AdrianCX/picohive-epaper/README.md

# Pico Planner

Standalone Raspberry Pi Pico 2 W E-Paper calendar \
Show next week items from Google Calendar\
Runs for 2 months on 4 AA Batteries

### Easy to check in the morning when it's hectic

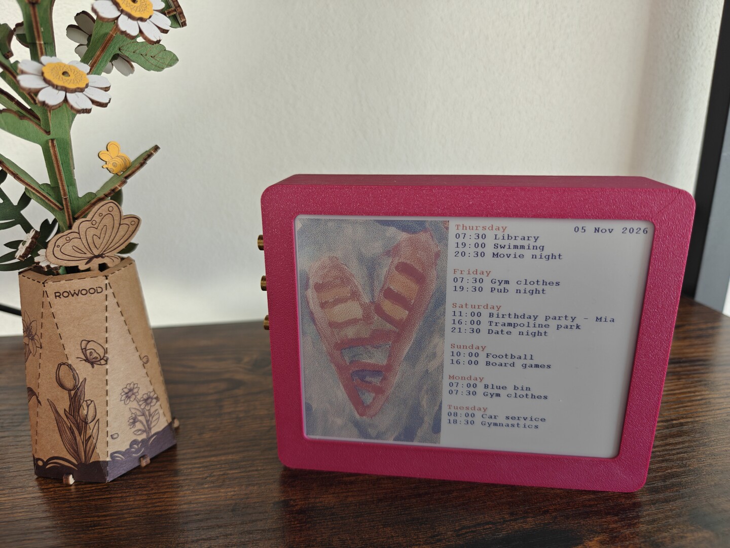
[picture p1: docs/pictures/1_main.jpg]
Standing in a bookshelf


### Simple build, few components

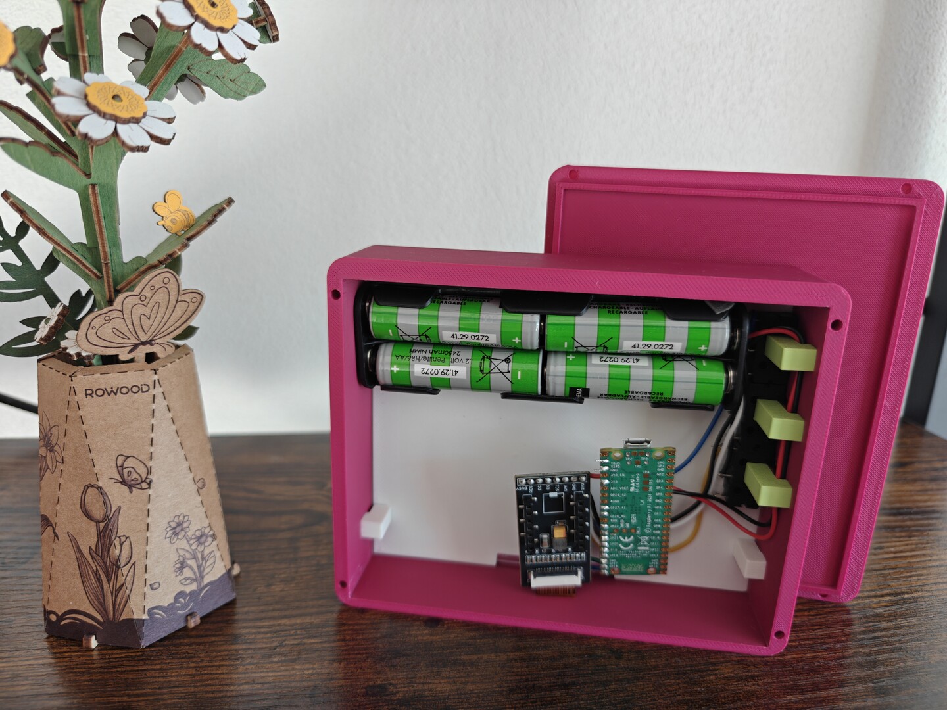
[picture p2: docs/pictures/2_back.jpg]
Inside


### How it looks disassembled

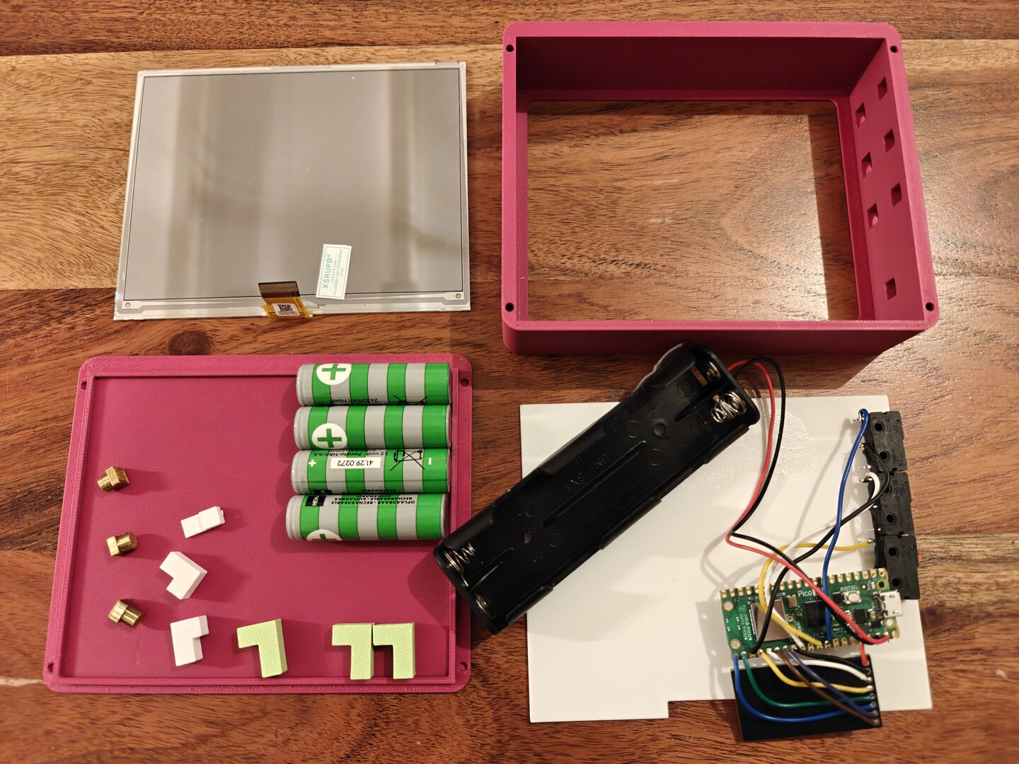
[picture p3: docs/assembly/1_assembly.jpg]
Putting it together


# Flashing and configuring

Check releases - two variants
- `epaper_color.uf2` - 5.65" 7 colour panel, 600x448 (Waveshare Pico-ePaper-5.65)
- `epaper_rb.uf2` - 5.83" black/white/red panel, 648x480 (Waveshare Pico-ePaper-5.83 (B))

Once flashed it will start in setup mode `picow_config` / `randompassword` ( http://192.168.4.1 ) \
Press KEY2 (GP26) to enter setup mode again\
Press KEY1 (GP22) to enter config mode and access on LAN

| | |
|---|---|
| Configure via web page, first wifi and login | Second, calendars and timezone |
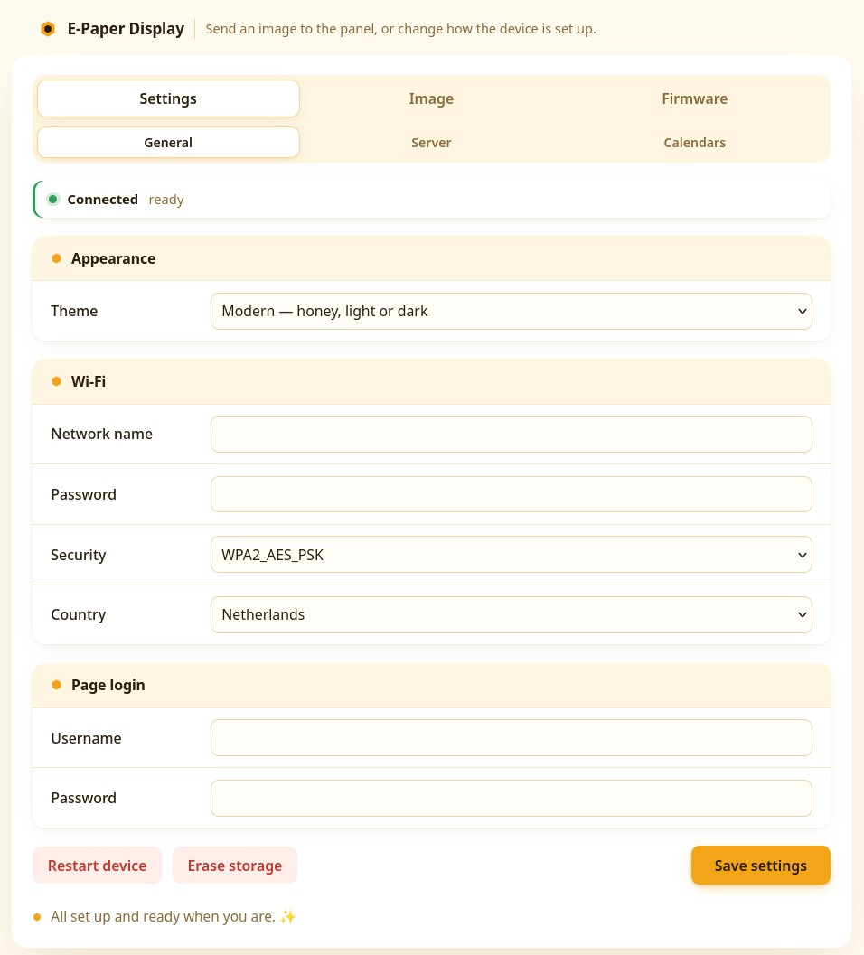
[picture p4: docs/webui/1_wifi.jpg]
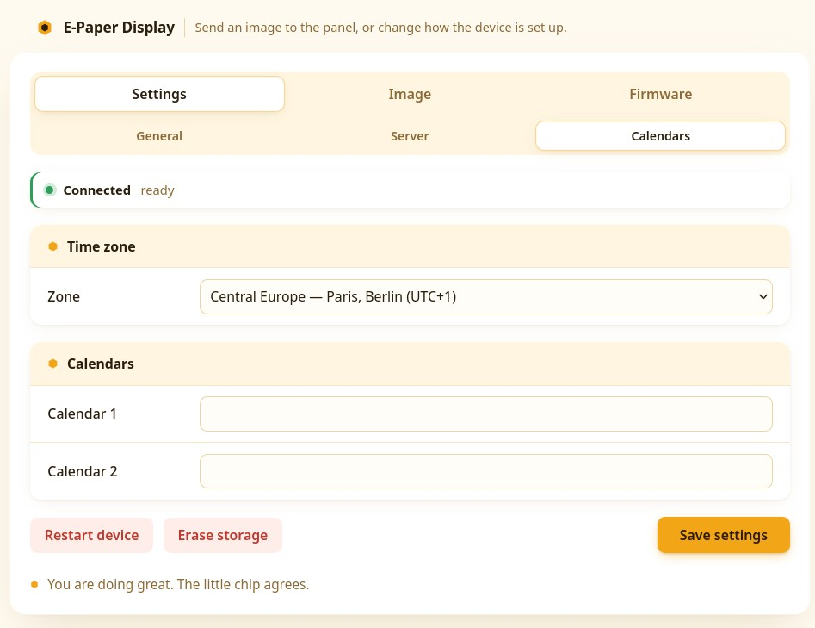
[picture p5: docs/webui/2_calendars.jpg]
|  |  |
| Third, pictures, limited slots | Last, updates go here when needed |
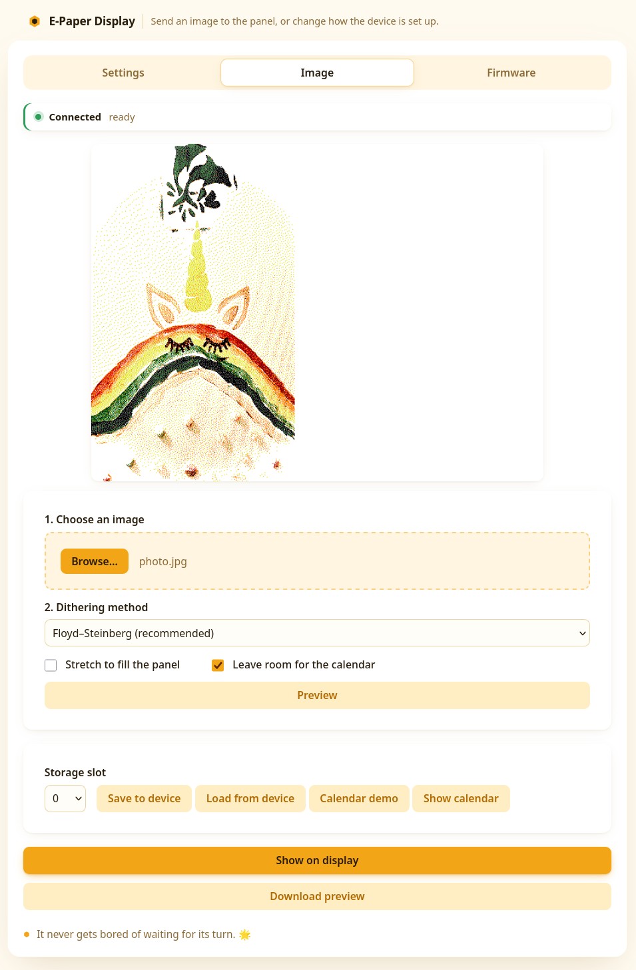
[picture p6: docs/webui/3_newpictures.jpg]
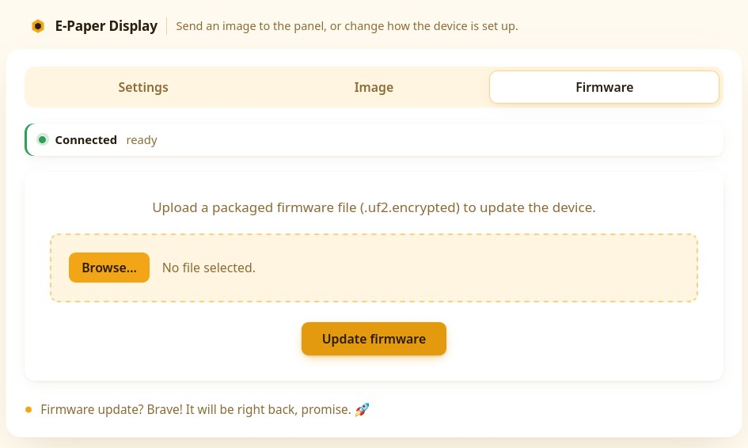
[picture p7: docs/webui/4_update.jpg]
|  |  |

Any iCal URL works (Google, Nextcloud, ...) \
It has a lot of goodies from [picohive-firmware](https://github.com/AdrianCX/picohive-firmware) like OTA, logs, crash reports ...\
You can set your own pictures from the web page, it dithers them itself

# How to get a calendar address from google

1. Open on desktop site [calendar.google.com](https://calendar.google.com)
2. Hover over calendar in "My calendars" and press the 3 dots then "Settings and Sharing"
3. Scroll down to "Secret address in iCal format" and copy that
4. Paste the calendar in the web page, save and reboot for it to be grabbed.

Notes:
- Web page stores config encrypted, doesn't echo or print it
- Calendar is fetched over HTTPS with root cert verification
- If you think it's leaked - there's a Reset button in google calendar to invalidate it

> [!TIP]
> To wipe it, flash [`flash_nuke.uf2`](https://github.com/Gadgetoid/pico-universal-flash-nuke) then the firmware again

# Firmware tutorial and build

Check out docs in [picohive-firmware](https://github.com/AdrianCX/picohive-firmware)

# How to build one

About 30€ for the red/black/white version, 45€ for the 7 colour one, plus printing (see 4.2):

| Part | Price |
|---|---|
| E-ink panel option 1: 5.83" black/white/red (648x480) | 14$ |
| E-ink panel option 2: 5.65" 7 colour (600x448)| 29$ |
| Raspberry Pi Pico 2 W | 9€ |
| ePaper breakout board for XIAO | 5€ |
| 4xAA battery holder with wires (NiMH rechargeables) | - |
| 3 push buttons, some wire | - |
| 3D printed frame, back and supports | - |

The holders plug into holes in the support, it all comes together without any screws. Use some superglue or tape and you're set.
If you need to adjust parts check out stl/scad folder - openscad is awesome

Assembly step 1

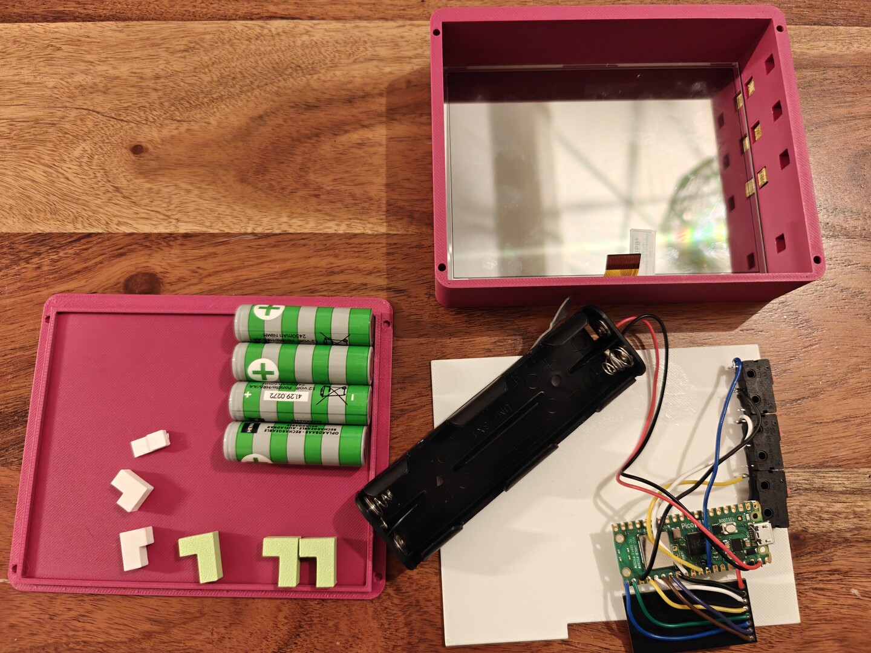
[picture p8: docs/assembly/2_assembly.jpg]
Assembly step 2


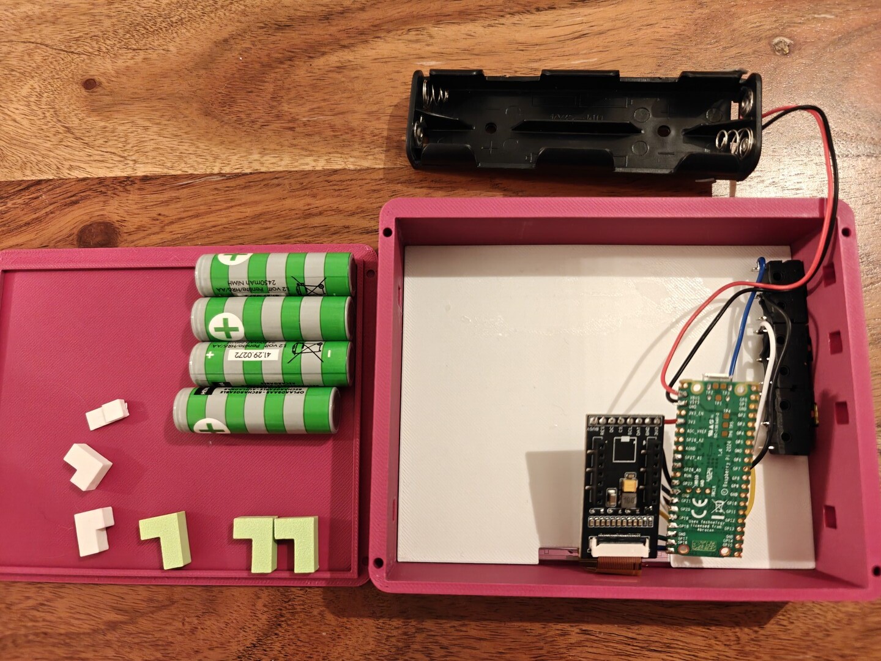
[picture p9: docs/assembly/3_assembly.jpg]
Assembly step 3


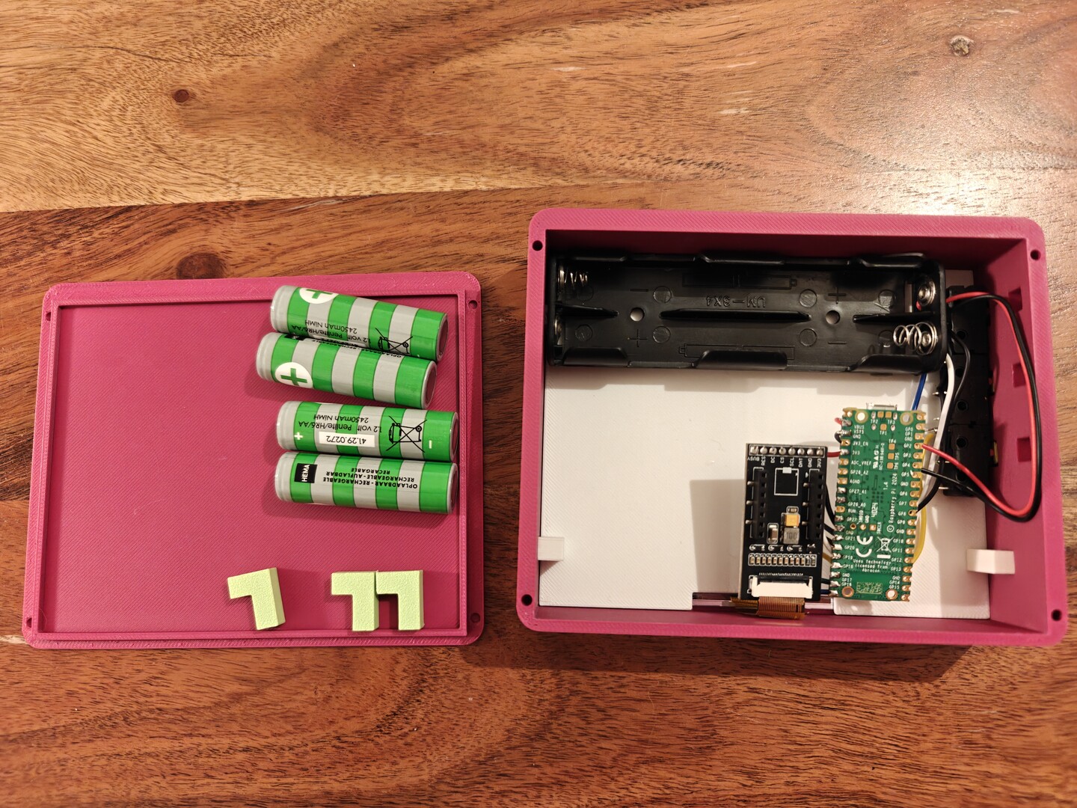
[picture p10: docs/assembly/4_assembly.jpg]
Assembly step 4


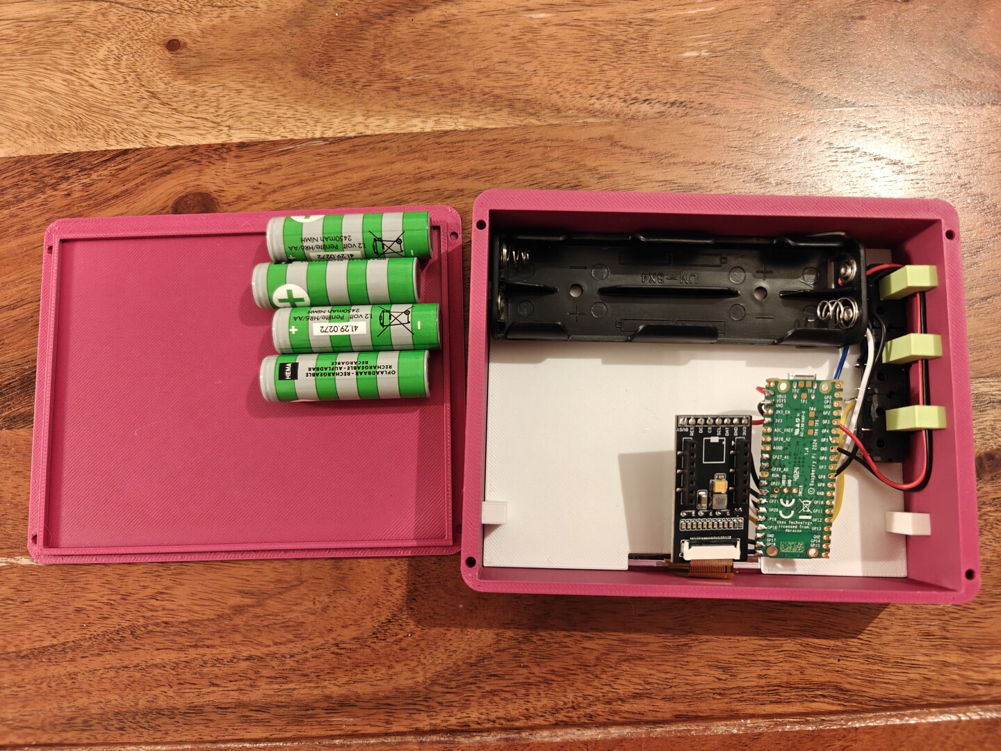
[picture p11: docs/assembly/5_assembly.jpg]
Assembly step 5


# 3D printed parts

Files in [stl/](stl/), each with its OpenSCAD source under the same name in [stl/scad/](stl/scad/):

| File | Count | What |
|---|---|---|
| [1_main.stl](stl/1_main.stl) | 1 | frame, holds the screen |
| [2_back.stl](stl/2_back.stl) | 1 | back cover |
| [3_small_foot.stl](stl/3_small_foot.stl) | 1 | short support |
| [4_button.stl](stl/4_button.stl) | 3 | button caps |
| [5_feet.stl](stl/5_feet.stl) | 2 | normal supports |
| [6_long_feet.stl](stl/6_long_feet.stl) | 3 | long supports |
| [7_screen_support.stl](stl/7_screen_support.stl) | 1 | plate behind the screen, the notch goes over the ribbon cable |

# Wiring

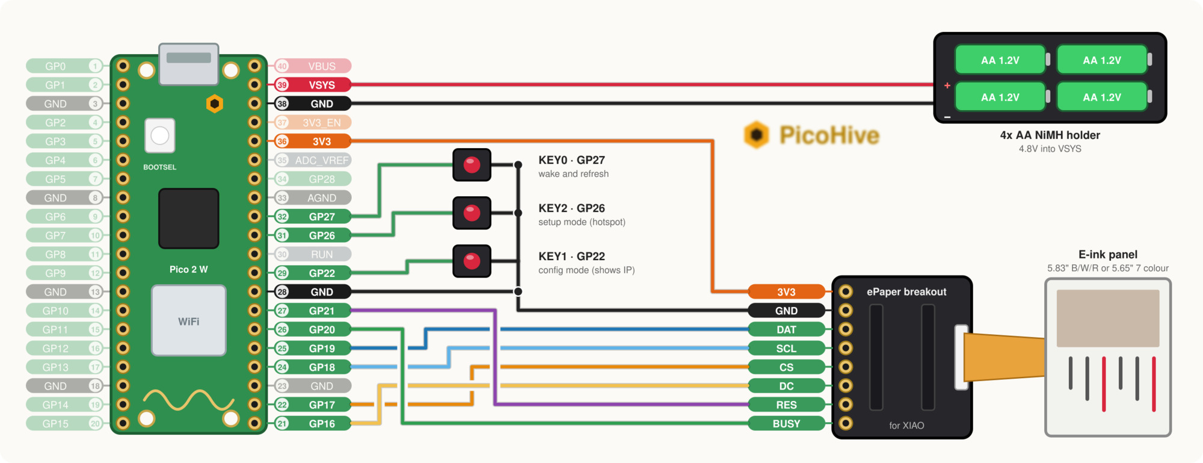
[picture p12: docs/pictures/04_wiring.jpg]
Wiring


- Panel: see actual picture for ribbon cable - don't plug it wrong way
- GPIOs: just follow picture above
- Battery holder: red to VSYS, black to GND

> [!WARNING]
> Careful with the ribbon cable, it's very easy to break where it joins the screen and make it unresponsive

You can adjust pins in `src/config/general_config.h`, if you wire it differently.\

# Some pictures to try out

| | | | |
|---|---|---|---|
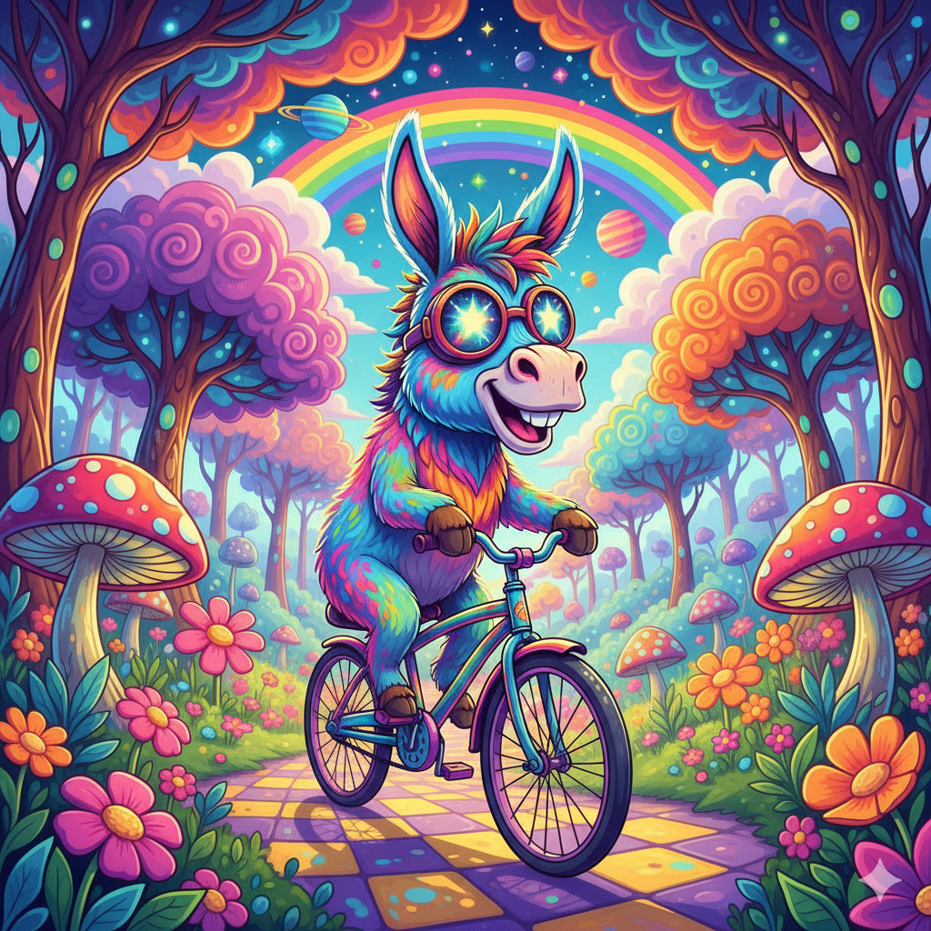
[picture p13: docs/transfer/2.jpg]
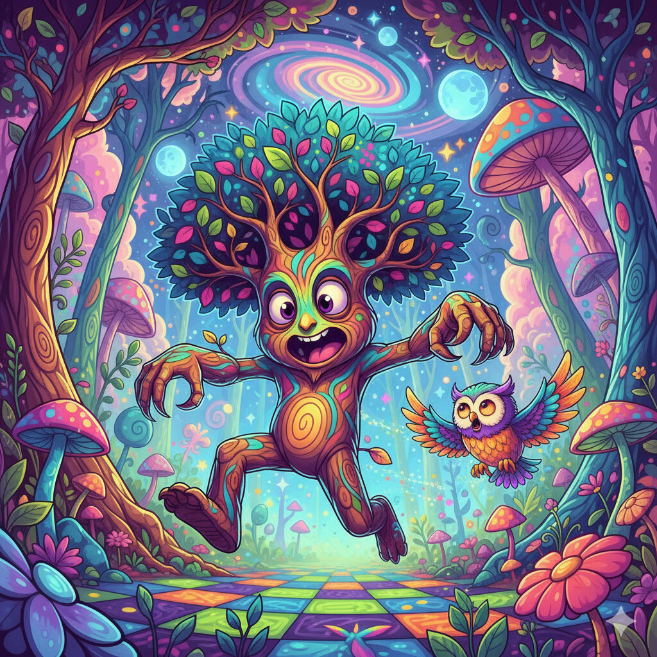
[picture p14: docs/transfer/4.jpg]
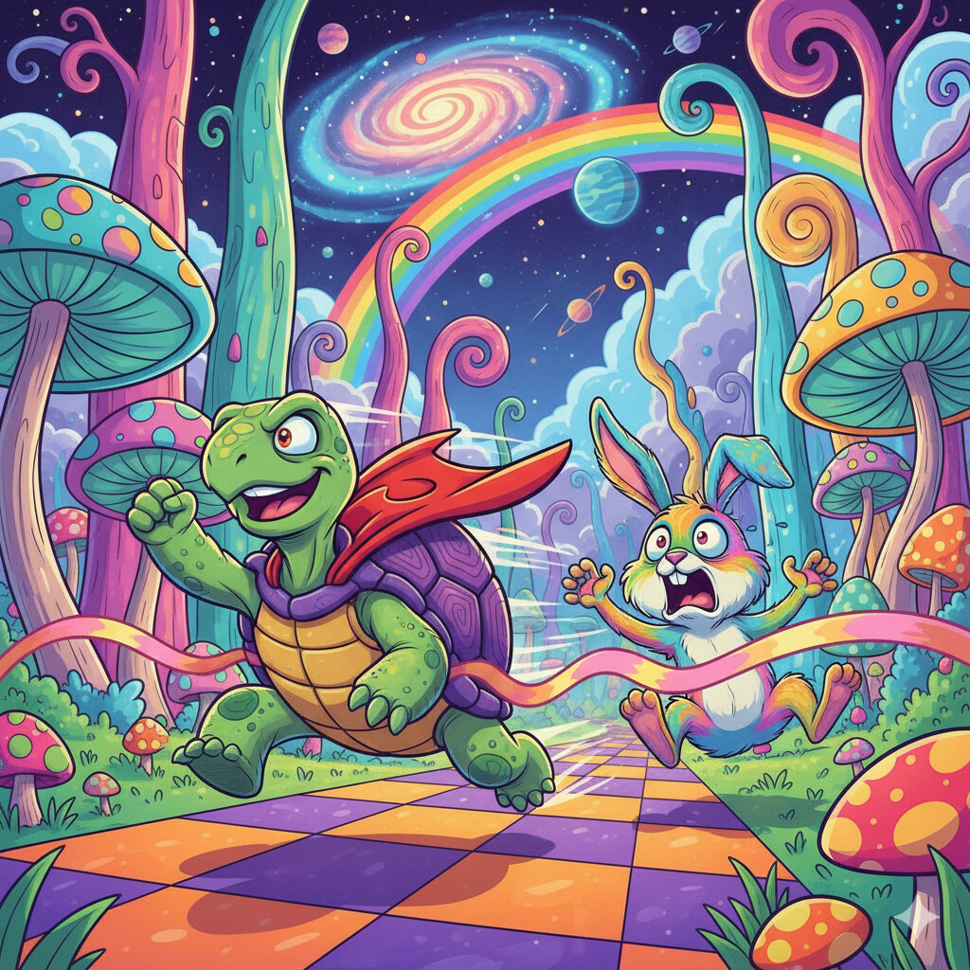
[picture p15: docs/transfer/5.jpg]
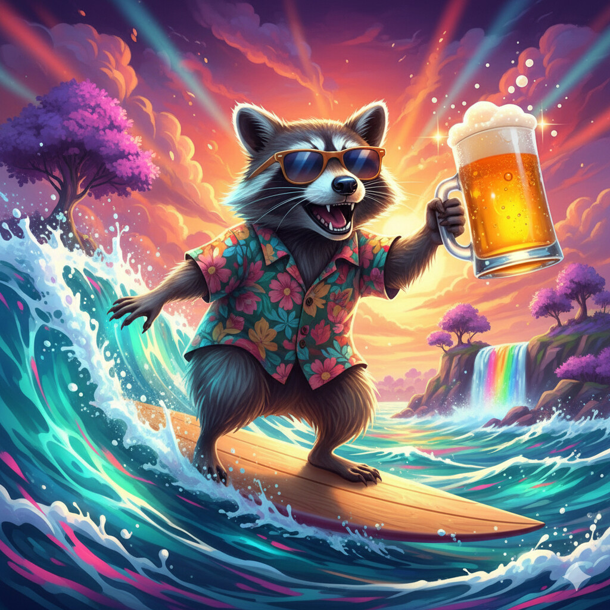
[picture p16: docs/transfer/pic1.jpg]
|  |  |  |  |
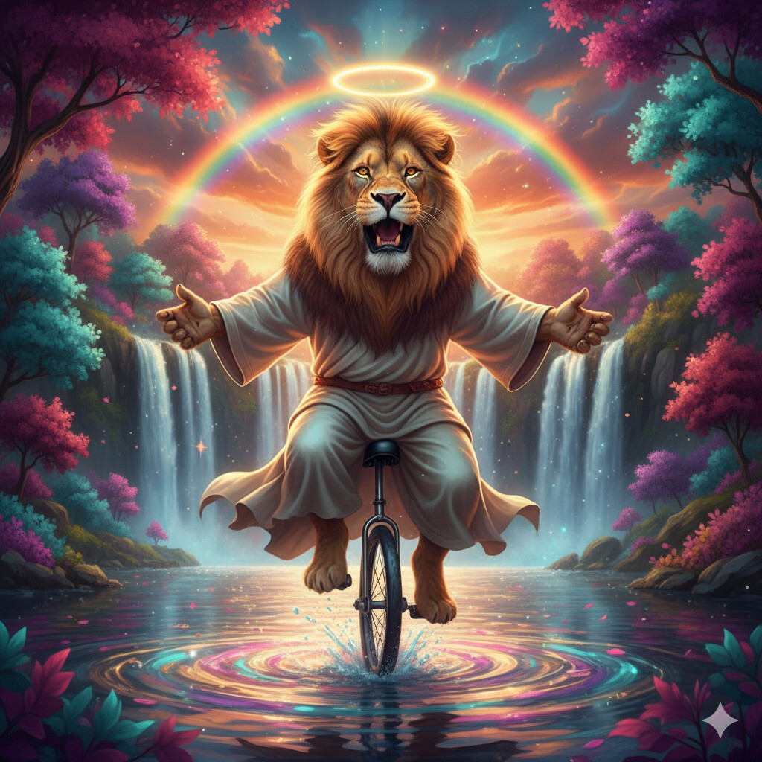
[picture p17: docs/transfer/pic2.jpg]
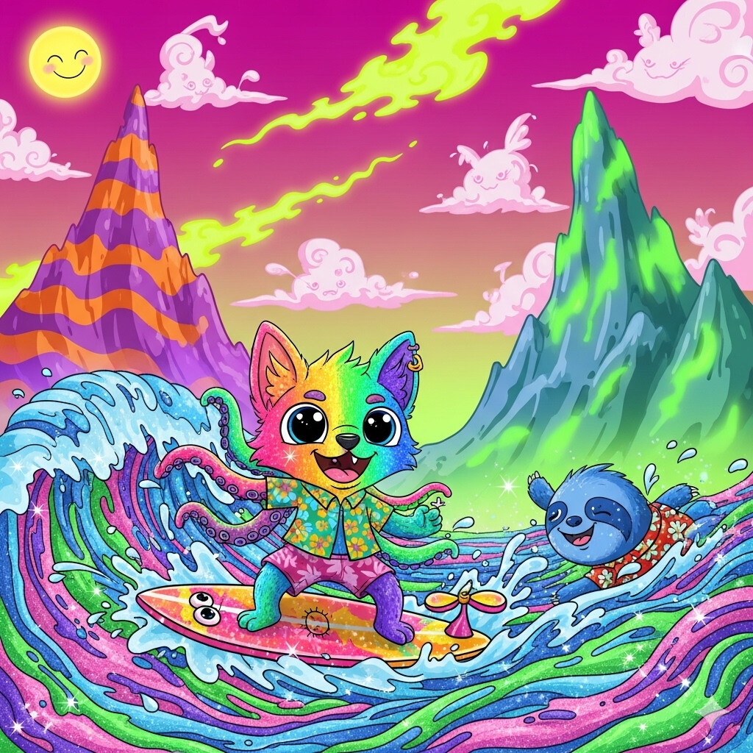
[picture p18: docs/transfer/pic3.jpg]
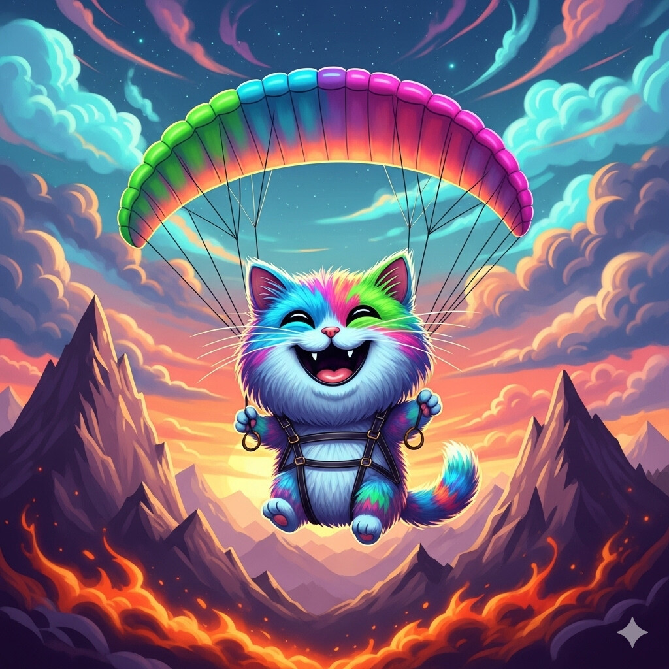
[picture p19: docs/transfer/pic4.jpg]
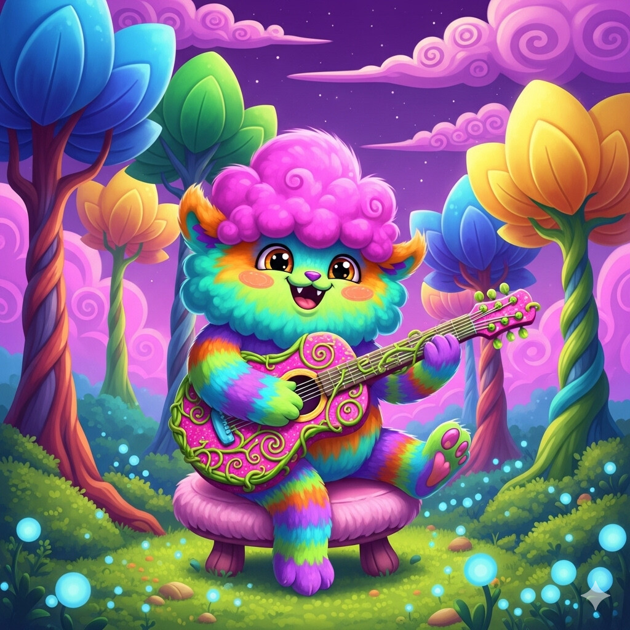
[picture p20: docs/transfer/pic5.jpg]
|  |  |  |  |
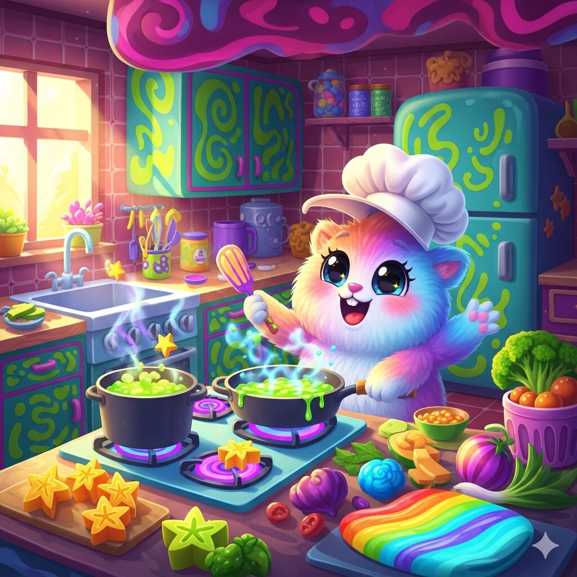
[picture p21: docs/transfer/pic6.jpg]
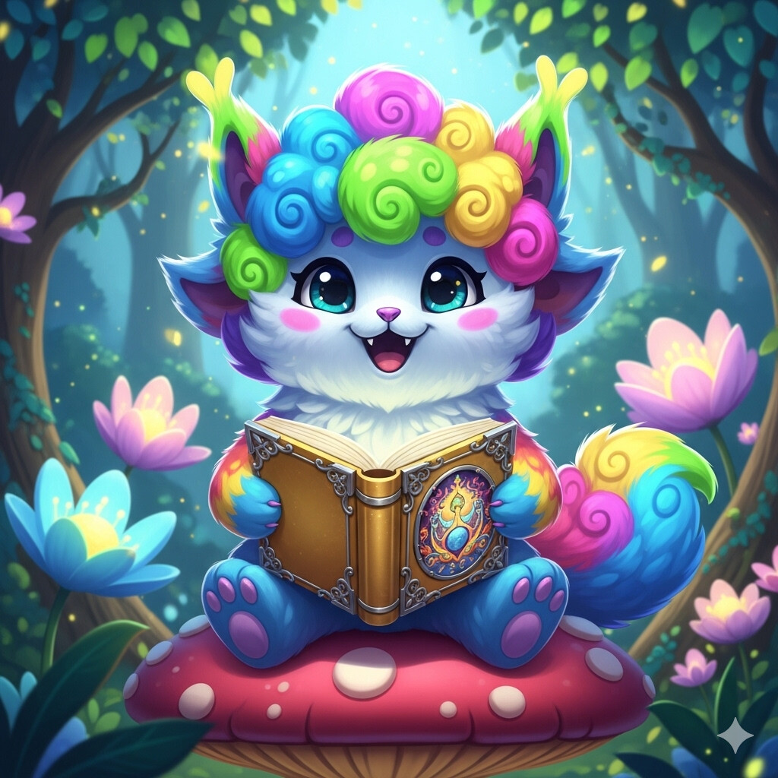
[picture p22: docs/transfer/pic7.jpg]
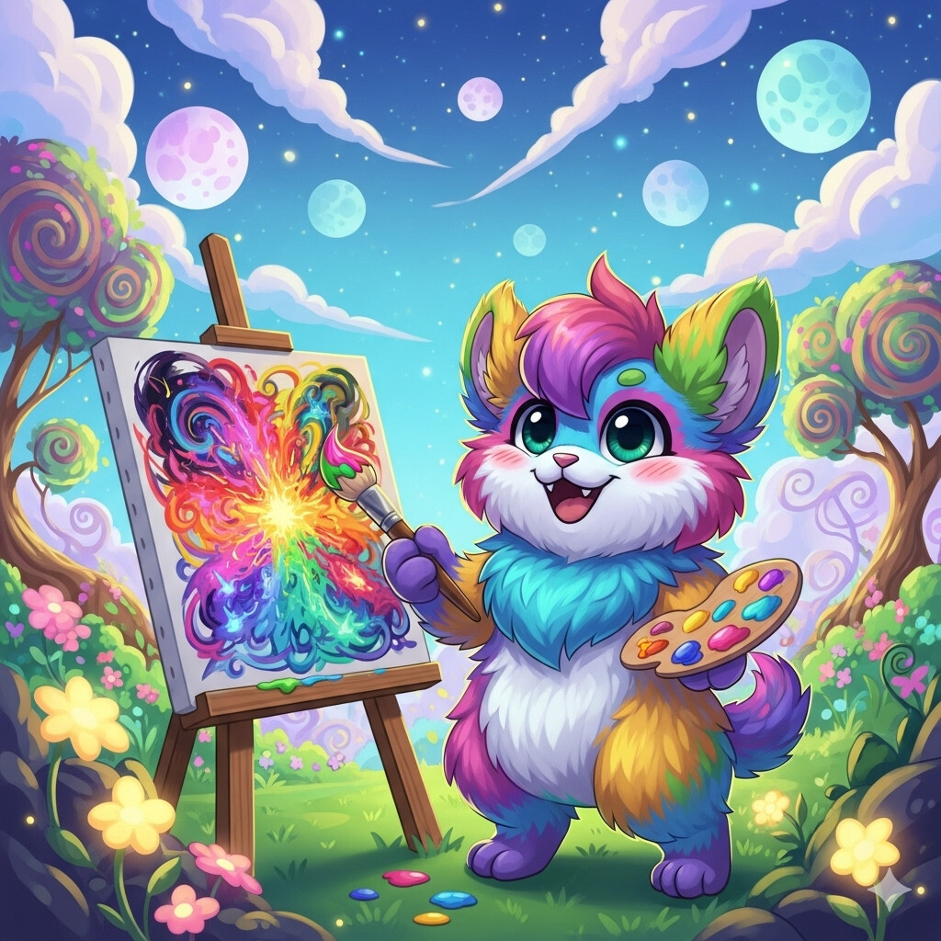
[picture p23: docs/transfer/pic8.jpg]
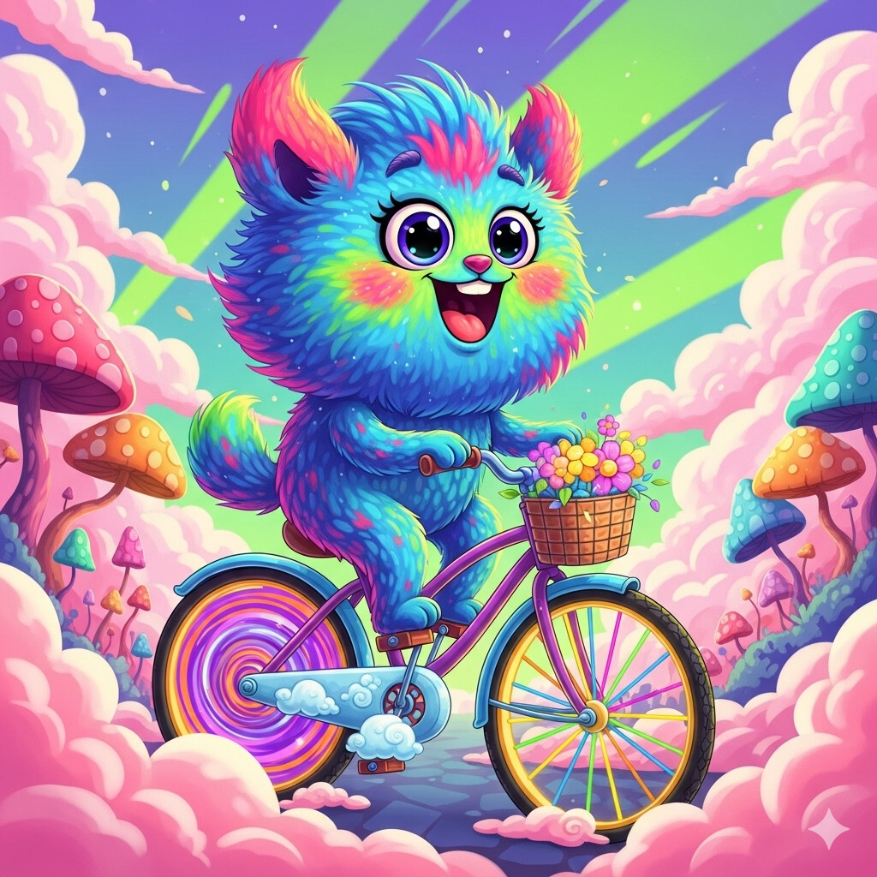
[picture p24: docs/transfer/pic9.jpg]
|  |  |  |  |
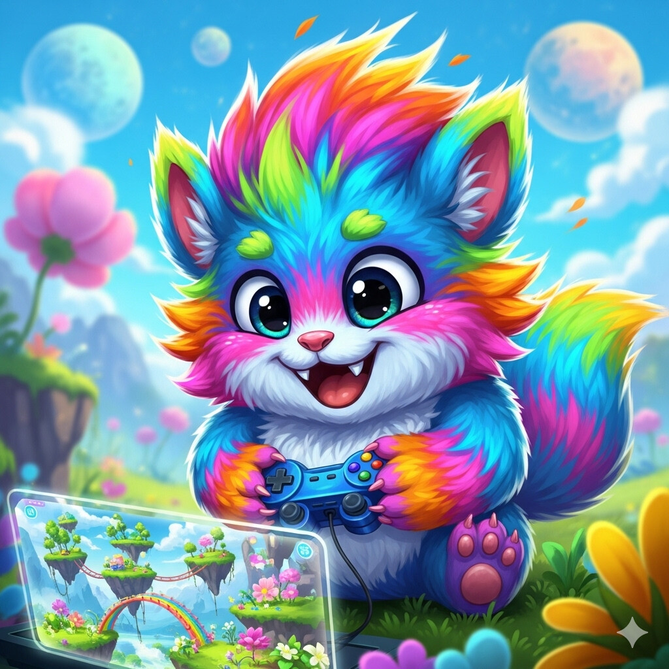
[picture p25: docs/transfer/pic10.jpg]
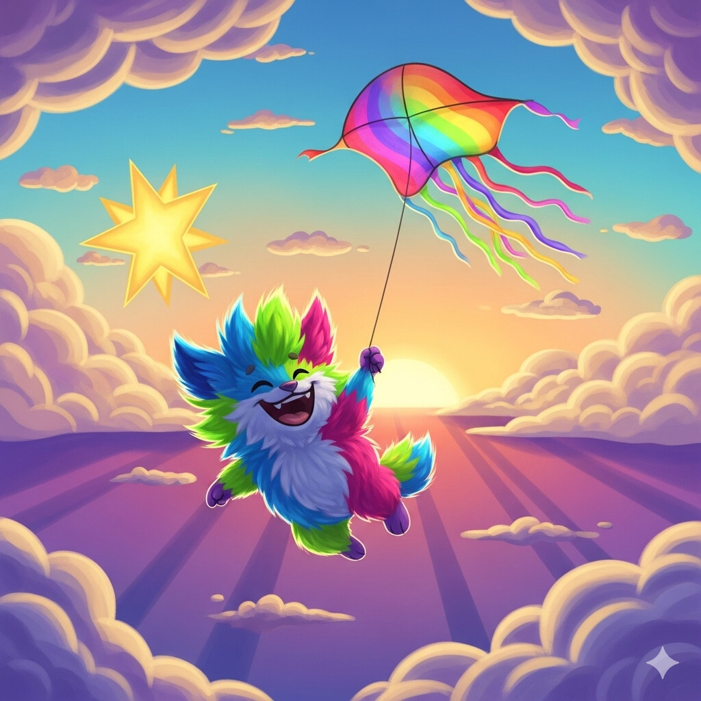
[picture p26: docs/transfer/pic11.jpg]
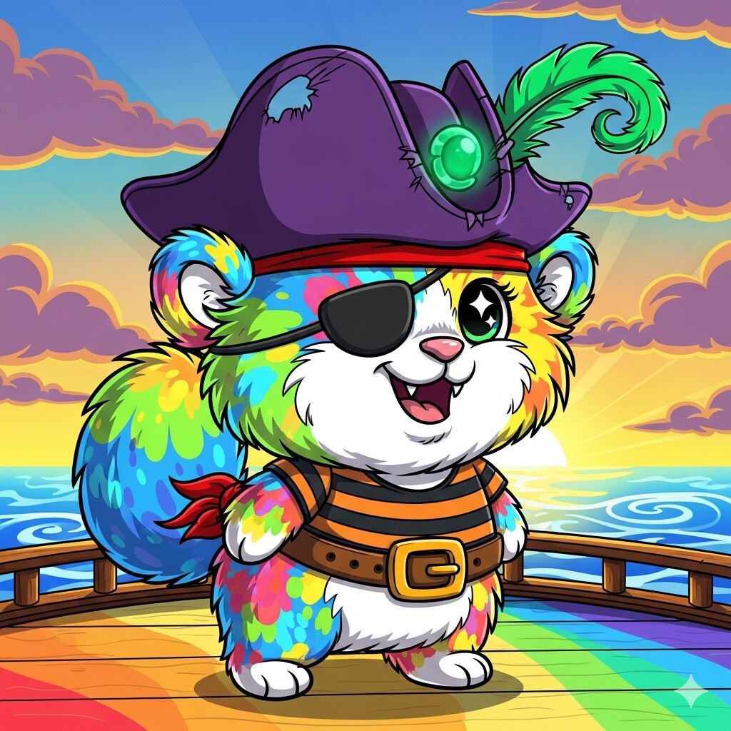
[picture p27: docs/transfer/pic12.jpg]
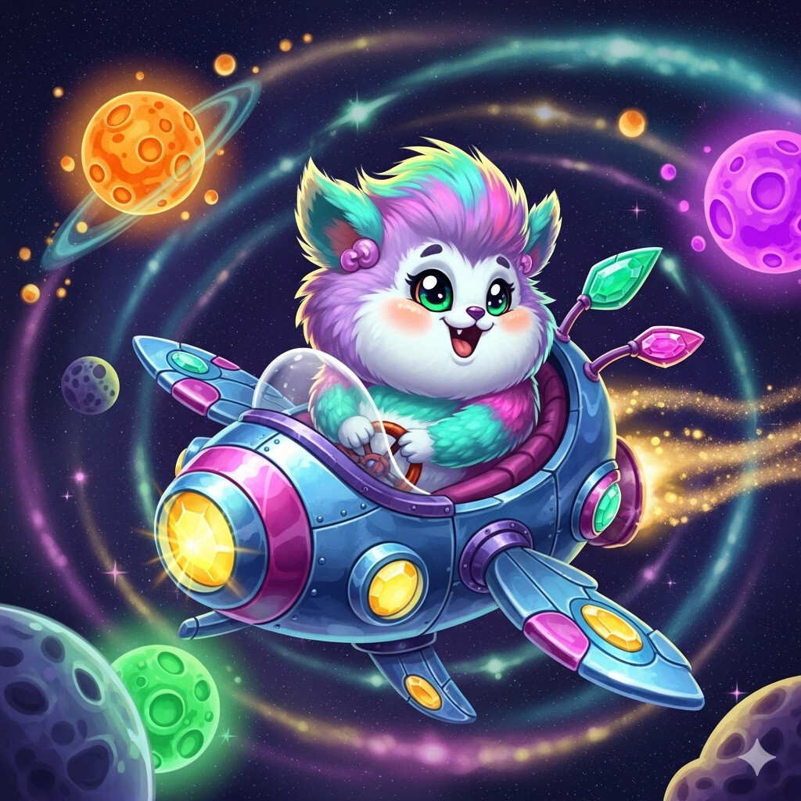
[picture p28: docs/transfer/pic13.jpg]
|  |  |  |  |
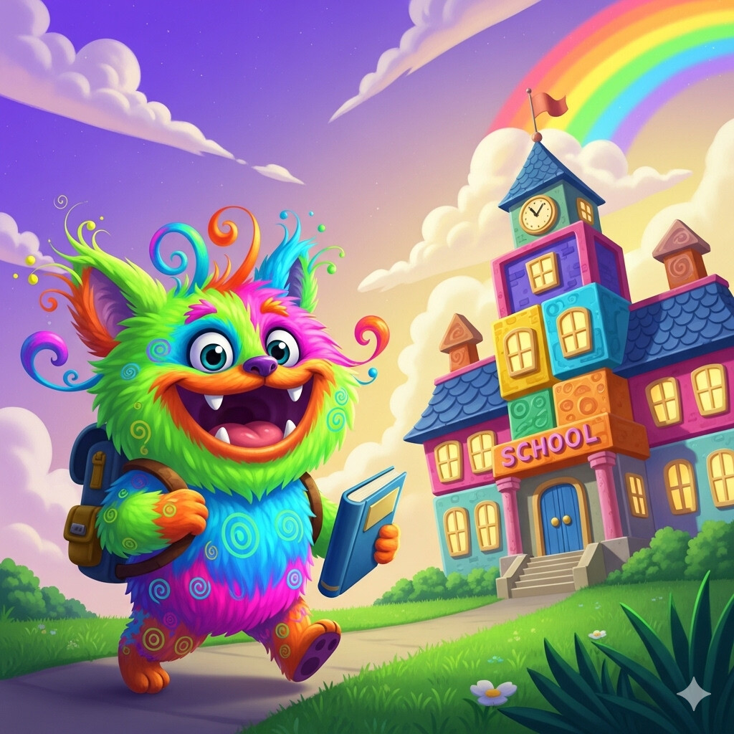
[picture p29: docs/transfer/pic14.jpg]
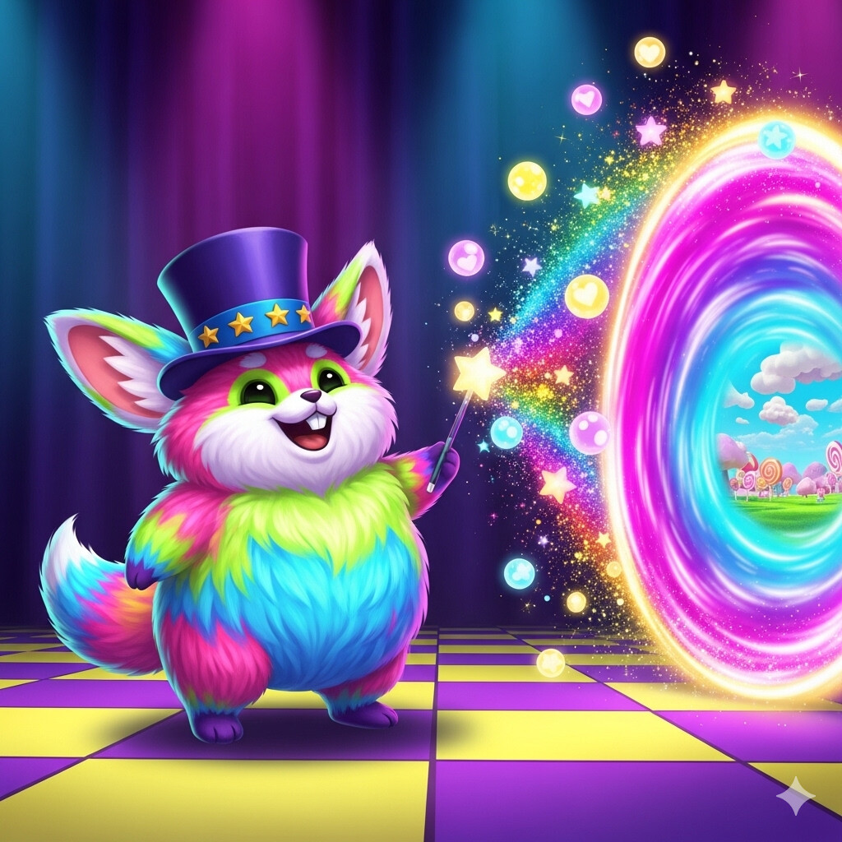
[picture p30: docs/transfer/pic15.jpg]
|  |  |  |  |

## License

AGPL-3.0-or-later for this app, see [LICENSE](LICENSE). The `os/` submodule is MPL-2.0, see its LICENSE.
