AdrianCX/picohive-epaper/docs/pictures/01_main.jpg

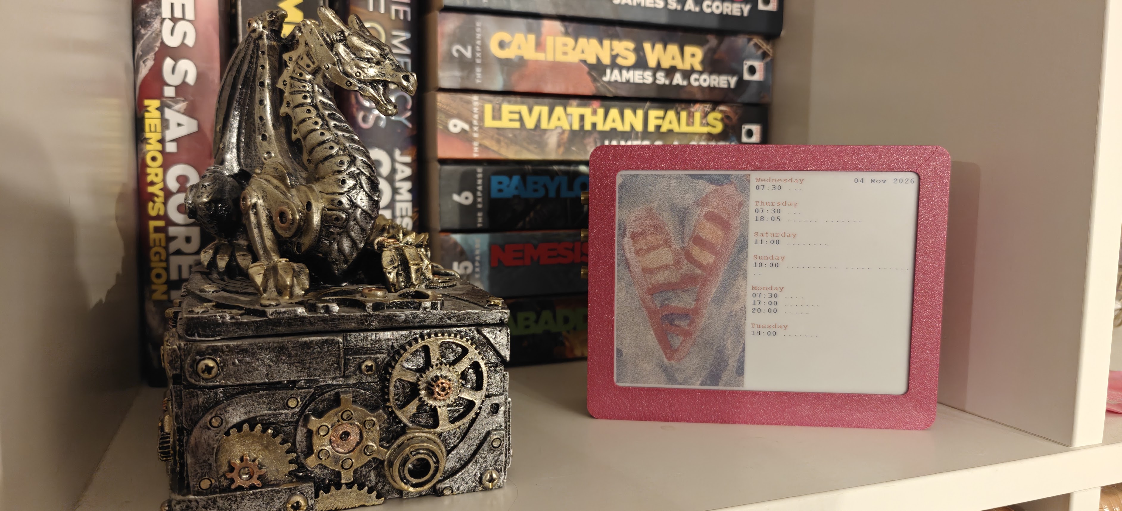
docs/pictures/01_main.jpg
