AdrianCX/picohive-epaper/docs/pictures/02_inside.jpg

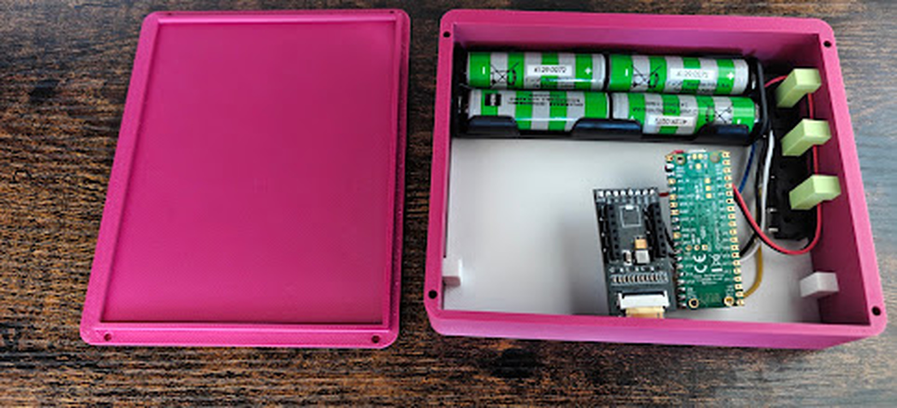
docs/pictures/02_inside.jpg
