AdrianCX/picohive-epaper/docs/pictures/03_back.jpg

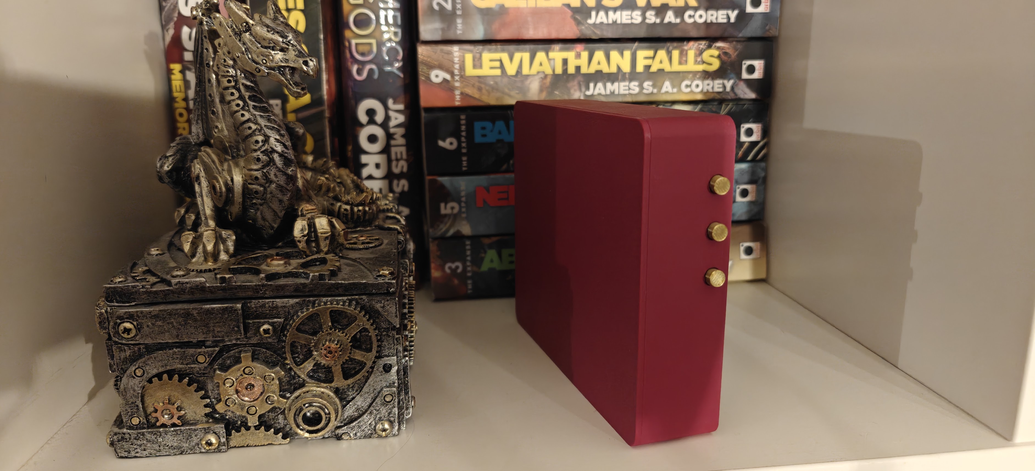
docs/pictures/03_back.jpg
