AdrianCX/picohive-epaper/stl/1_main.stl

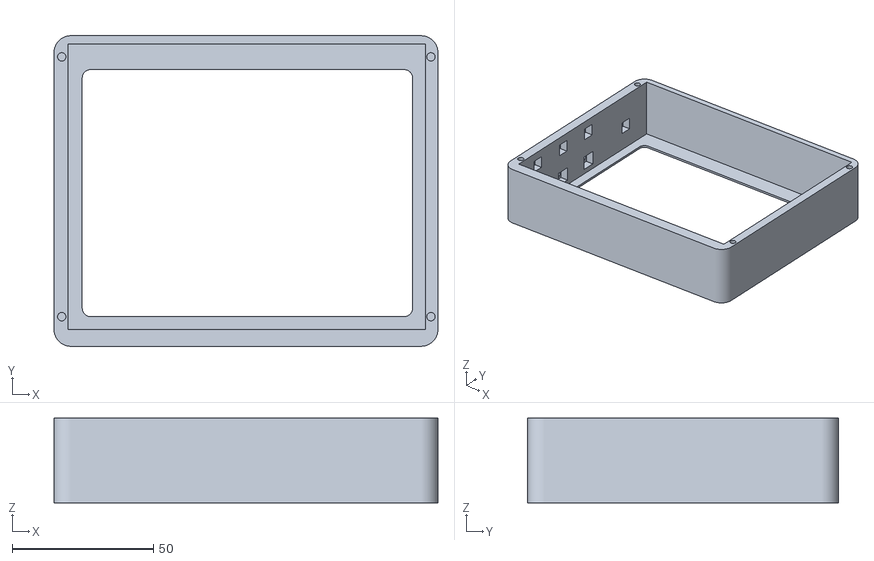
[picture p34: CAD file, 2026-11-04]
stl/1_main.stl
136.0 x 110.0 x 30.0
