AdrianCX/picohive-epaper/stl/2_back.stl

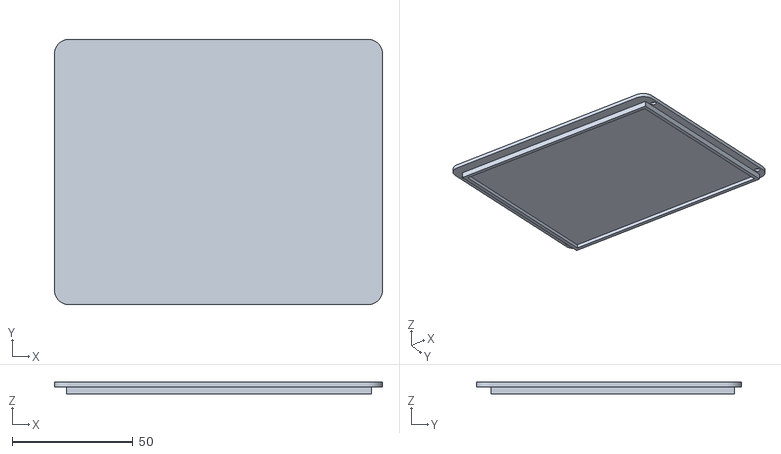
[picture p35: CAD file, 2026-11-04]
stl/2_back.stl
136.0 x 110.0 x 5.00
