AdrianCX/picohive-epaper/stl/6_long_feet.stl

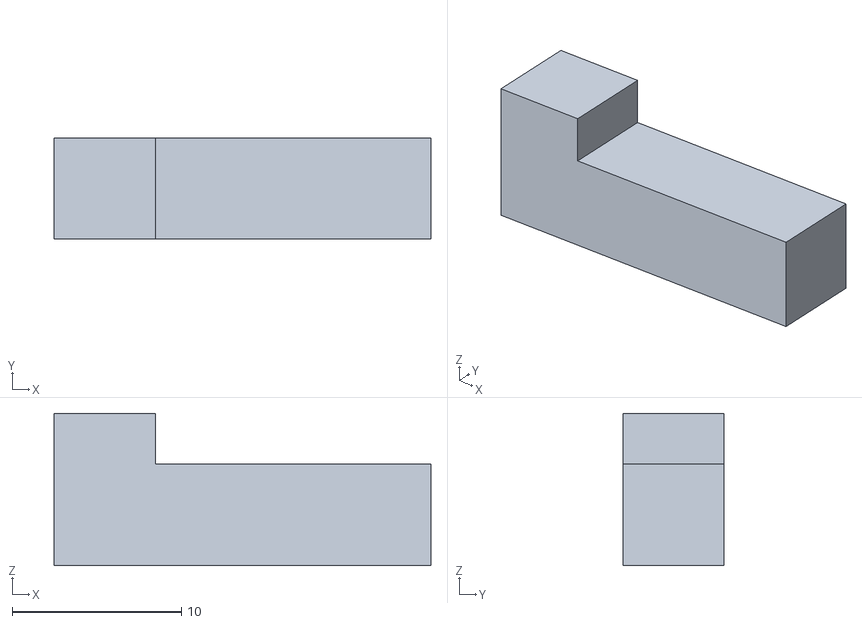
[picture p36: CAD file, 2026-11-04]
stl/6_long_feet.stl
22.3 x 6.00 x 9.00
