AdrianCX/picohive-epaper/stl/7_screen_support.stl

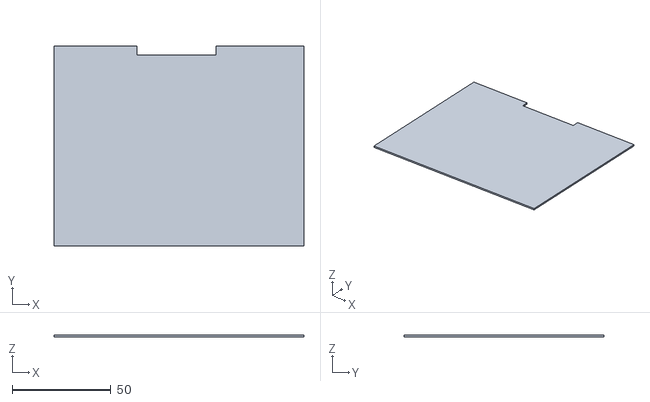
[picture p37: CAD file, 2026-11-04]
stl/7_screen_support.stl
126.5 x 101.0 x 1.00
