AdrianCX/picohive-epaper/stl/5_feet.stl

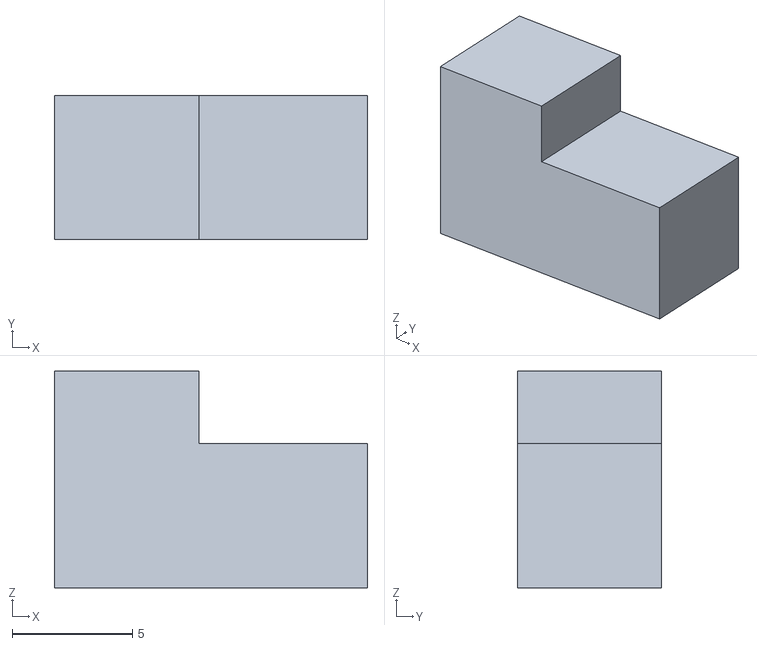
[picture p38: CAD file, 2026-11-04]
stl/5_feet.stl
13.0 x 6.00 x 9.00
