AdrianCX/picohive-epaper/stl/3_small_foot.stl

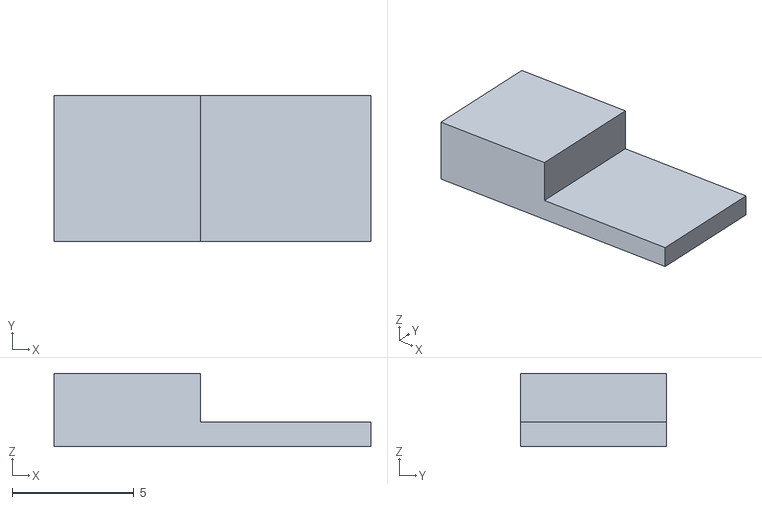
[picture p39: CAD file, 2026-11-04]
stl/3_small_foot.stl
13.0 x 6.00 x 3.00
