AdrianCX/picohive-epaper/stl/4_button.stl

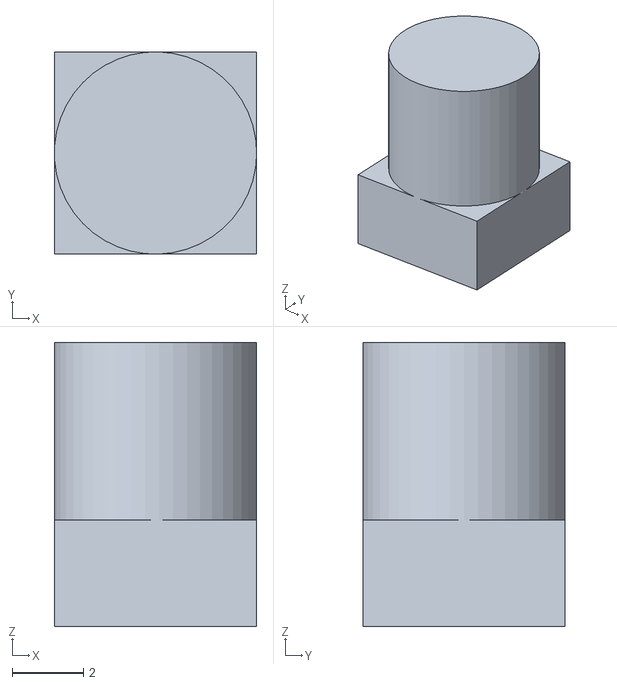
[picture p40: CAD file, 2026-11-04]
stl/4_button.stl
5.70 x 5.70 x 8.00
