AdrianCX/picohive-epaper/stl/scad/3_small_foot.scad

cube([6, 6, 3]);
cube([13, 6, 1]);
