AdrianCX/picohive-epaper/stl/scad/4_button.scad

$fa = 1;
$fs = 0.4;

size = 5.7;
cylinder(h = 8, d = size);
translate([-size/2, -size/2, 0]) cube([size, size, 3]);
