AdrianCX/picohive-epaper/stl/scad/5_feet.scad

cube([6, 6, 9]);
cube([13, 6, 6]);
