AdrianCX/picohive-epaper/stl/scad/6_long_feet.scad

cube([6, 6, 9]);
cube([22.3, 6, 6]);
