AdrianCX/picohive-epaper/stl/scad/7_screen_support.scad

difference() {
    translate([8, 8.5, 0]) cube([126.5, 101, 1]);
    translate([50, 105, 0]) cube([40, 5, 3]);
}
